doublEElectronics/100W-LED-DRIVER/README.md

100W-LED-DRIVER
===============

A LM3409HV based driver to run 2.5A-3.5A leds with various config options
