doublEElectronics/100W-LED-DRIVER/BOM100Wled.xls

√ | Descripition | ID | Manufacturer | Part Number | Amount | Distributor | Price 10 | Price 100 | Price 1000 | Tot Price 10 | Tot Price 100 | Tot Price 1000 | Website
Silicon
 | IC LED DRIVR HIGH BRIGHT 10-MSOP | U1 | Texas Instruments | LM3409HV | 1.00 | Digikey | $1.94 | $1.57 | $0.84 | $1.94 | $1.57 | $0.84 | http://www.digikey.com/product-detail/en/LM3409HVMY%2FNOPB/LM3409HVMY%2FNOPBCT-ND/2080449
 | MOSFET P-CH 60V 14A TO252 | Q1 | Diodes Inc | DMP6180SK3-13 | 1.00 | Digikey | $0.61 | $0.38 | $0.29 | $0.61 | $0.38 | $0.29 | http://www.digikey.com/product-detail/en/DMP6180SK3-13/DMP6180SK3-13DICT-ND/3983752
 | DIODE SCHOTTKY 150V 6A TO252AA | D1 | IXYS | DSS6-015AS | 1.00 | Digikey | $1.02 | $0.81 | $0.50 | $1.02 | $0.81 | $0.50 | http://www.digikey.com/product-detail/en/DSS6-015AS/DSS6-015ASCT-ND/3139305
Passive
 | RES 0.47 OHM 1/4W 1% 1206 SMD | R7,R8 | Bourns Inc. | CRL1206-FW-R470ELF | 2.00 | Digikey | $0.26 | $0.10 | $0.05 | $0.52 | $0.21 | $0.10 | http://www.digikey.com/product-detail/en/CRL1206-FW-R470ELF/CRL1206-FW-R470ELFCT-ND/3925477
 | RES 6.98K OHM 1/8W 1% 0805 | R3 | Samsung | RC2012F6981CS | 1.00 | Digikey | $0.02 | $0.01 | $0.0037 | $0.02 | $0.01 | $0.0037 | http://www.digikey.com/product-detail/en/RC2012F6981CS/1276-5322-1-ND/3968294
 | RES 49.9K OHM 1/8W 1% 0805 | R4 | Samsung | RC2012F4992CS | 1.00 | Digikey | $0.02 | $0.01 | $0.0037 | $0.02 | $0.01 | $0.0037 | http://www.digikey.com/product-detail/en/RC2012F4992CS/1276-5378-1-ND/3968350
 | INDUCTOR 33UH 3.4A SMD | L1 | Bourns Inc. | SDR2207-330YL | 1.00 | Digikey | $1.05 | $0.80 | $0.80 | $1.05 | $0.80 | $0.80 | http://www.digikey.com/product-detail/en/SDR2207-330YL/SDR2207-330YLCT-ND/3741510
 | RES 0.08 OHM 3W 1% 2512 SMD | R6 | Bourns Inc. | CRA2512-FZ-R080ELF | 1.00 | Digikey | $0.50 | $0.34 | $0.23 | $0.50 | $0.34 | $0.23 | http://www.digikey.com/product-detail/en/2-2176057-1/A109690CT-ND/4032456
 | CAP CER 470PF 50V 10% X7R 0805 | C5 | Samsung | CL21B471KBANNNC | 1.00 | Digikey | $0.05 | $0.02 | $0.01 | $0.05 | $0.02 | $0.01 | http://www.digikey.com/product-detail/en/CL21B471KBANNNC/1276-1300-1-ND/3889386
 | RES 68.1K OHM 1/8W 1% 0805 SMD | R5 | Yageo | RC0805FR-0768K1L | 1.00 | Digikey | $0.02 | $0.01 | $0.00379 | $0.02 | $0.01 | $0.00379 | http://www.digikey.com/product-detail/en/RC0805FR-0768K1L/311-68.1KCRCT-ND/731047
 | CAP CER 1UF 16V 10% X7R 0805 | C3 | Samsung | CL21B105KOFNNNE | 1.00 | Digikey | $0.07 | $0.03 | $0.02 | $0.07 | $0.03 | $0.02 | http://www.digikey.com/product-detail/en/CL21B105KOFNNNE/1276-1026-1-ND/3889112
 | CAP CER 2.2UF 100V 10% X7R 1210 | C1,C2,C6 | Taiyo Yuden | HMK325B7225KN-T | 3.00 | Digikey | $0.54 | $0.26 | $0.18 | $1.61 | $0.78 | $0.54 | http://www.digikey.com/product-detail/en/HMK325B7225KN-T/587-1778-1-ND/1212794
 | RES 1.00K OHM 1/8W 1% 0805 SMD | R1,R2 | Yageo | RC0805FR-071KL | 2.00 | Digikey | $0.02 | $0.01 | $0.00379 | $0.04 | $0.02 | $0.01 | http://www.digikey.com/product-detail/en/RC0805FR-071KL/311-1.00KCRCT-ND/730391
Connectors
 | BERGSTIK II .100" 36 1RW MALE HEADER | J2 | FCI | 68000-236HLF | 0.08 | Digikey | $0.71 | $0.64 | $0.64 | $0.06 | $0.05 | $0.05 | http://www.digikey.com/product-detail/en/68000-236HLF/609-3465-ND/2023290
 | BERGSTIK II .100" 72 2RW MALE HEADER | J3 | FCI | 67996-272HLF | 0.11 | Digikey | $2.00 | $1.71 | $1.22 | $0.22 | $0.19 | $0.14 | http://www.digikey.com/product-detail/en/67996-272HLF/609-3493-ND/1486883
 | TERMINAL BLOCK 3.5MM 2POS PCB | J1,J4 | OST | OSTTE020104 | 1.00 | Digikey | $0.34 | $0.24 | $0.17 | $0.34 | $0.24 | $0.17 | http://www.digikey.com/product-detail/en/OSTTE020104/ED2740-ND/2351816
 |  |  |  |  |  |  |  | Total |  | $8.10 | $5.45 | $3.71
