doublEElectronics/100W-LED-DRIVER/schematic.pdf

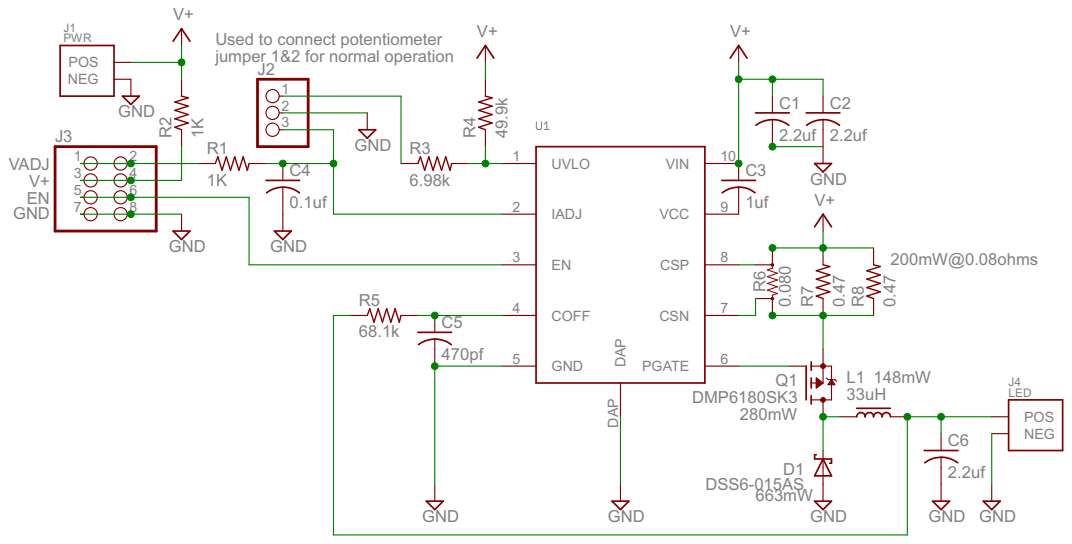
[picture p1: page 1]

Used to connect potentiometer
