doublEElectronics/100W-LED-DRIVER/100Wdriver.brd

## EAGLE design 100Wdriver.brd (2014-07-20)

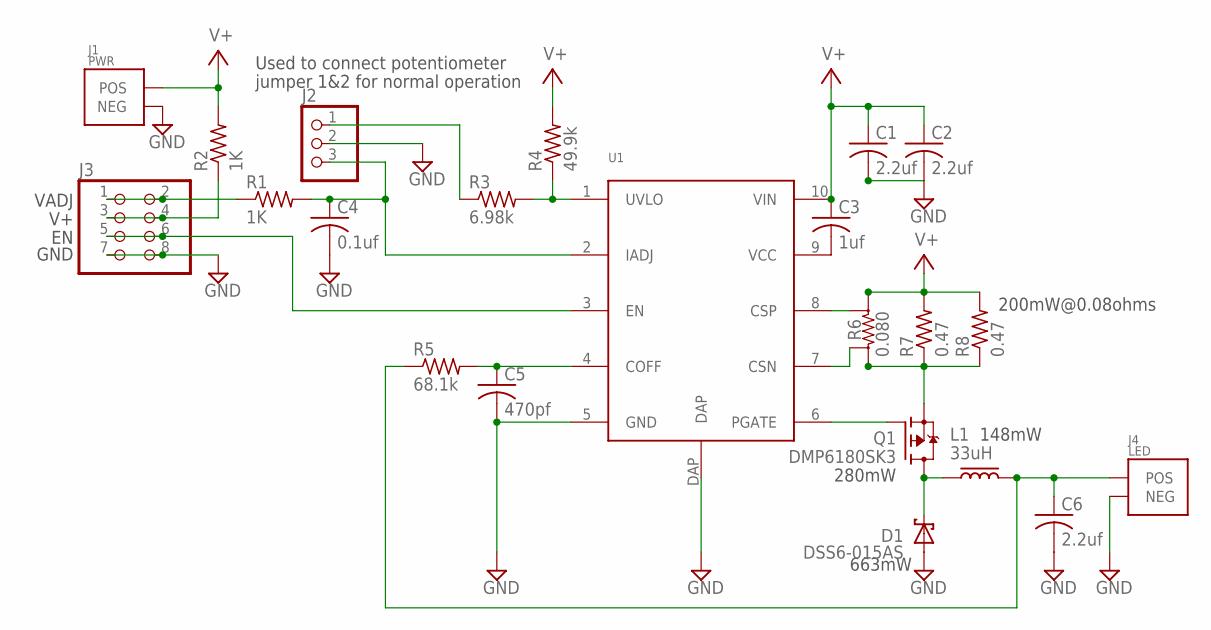
[picture p2: schematic 100Wdriver.sch]

Parts:
C1, C2, C6: 2.2uf; C1210
C3: 1uf; C0805
C4: 0.1uf; C0805
C5: 470pf; C0805
D1: DSS6-015AS; D-PAK_TO252AA
J1: PWR; 3.5MMLEFT
J2: PINHD-1X3; 1X03
J3: PINHD-2X4; 2X04
J4: LED; 3.5MM
L1: 33uH; SDR2207
Q1: DMP6180SK3; TO252
R1, R2: 1K; R0805
R3: 6.98k; R0805
R4: 49.9k; R0805
R5: 68.1k; R0805
R6: 0.080; 2512SENSE
R7, R8: 0.47; R1206
U1: LM3409HV; 10VSSOP

Connections:
EN: J3.5, J3.6, U1.3 (EN)
GND: C1.2, C2.2, C4.2, C5.2, C6.2, D1.1 (A), D1.3 (A), J1.GND (NEG), J2.2, J3.7, J3.8, J4.NEGATIVE (NEG), U1.5 (GND), U1.DAP
IADJ: C4.1, J2.3, R1.2, U1.2 (IADJ)
unnamed: Q1.2 (S), R6.P$3, R6.P$4, R7.1, R8.1
unnamed: C5.1, R5.2, U1.4 (COFF)
unnamed: R3.2, R4.1, U1.1 (UVLO)
unnamed: D1.4 (C), L1.P$1, Q1.3 (D)
unnamed: C3.2, U1.9 (VCC)
unnamed: Q1.1 (G), U1.6 (PGATE)
unnamed: C6.1, J4.POSITIVE (POS), L1.P$2, R5.1
unnamed: J3.1, J3.2, R1.1
unnamed: J2.1, R3.1
unnamed: J3.3, J3.4, R2.1
unnamed: R6.SNS1, U1.8 (CSP)
unnamed: R6.SNS2, U1.7 (CSN)
V+: C1.1, C2.1, C3.1, J1.V+ (POS), R2.2, R4.2, R6.P$1, R6.P$2, R7.2, R8.2, U1.10 (VIN)

Notes on the sheet:
GND
VADJ
Used to connect potentiometer
jumper 1&2 for normal operation
280mW
663mW
148mW
200mW@0.08ohms

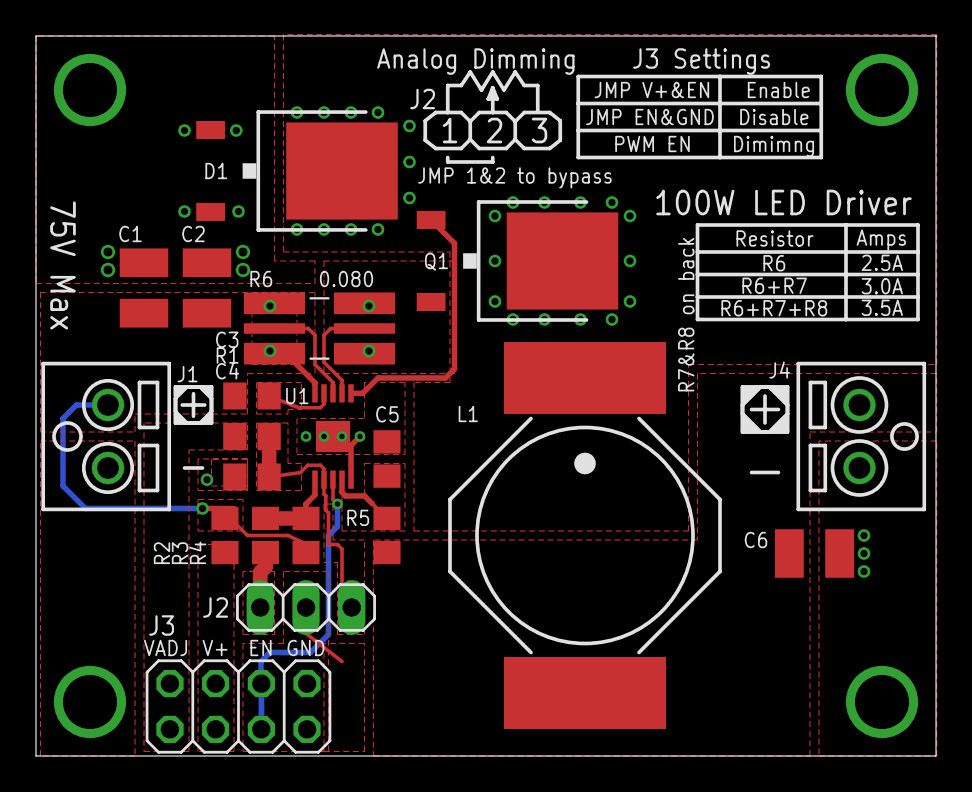
[picture p3: board 100Wdriver.brd from above]

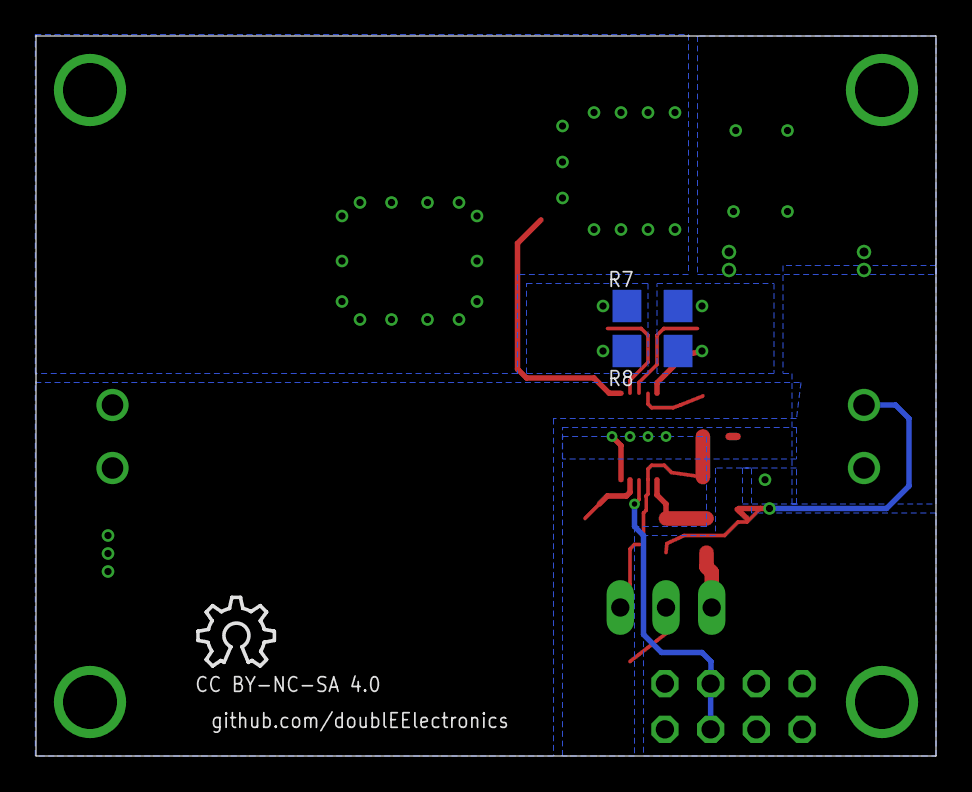
[picture p4: board 100Wdriver.brd from below]

Board: 2 copper layers, 50.0 x 40.0 mm, 23 parts (3 on the bottom side), 16 nets.

Other parts of the board:
U$1: OSHW_8X150_NOTEXT
