doublEElectronics/100W-LED-DRIVER/(notices)

Notices in the files:
100Wdriver.brd:
CC BY-NC-SA 4.0
